BasselKhaled24/Gyroscopic-Boat-Stabilization-System/README.md

# Gyroscopic-Boat-Stabilization-System
This is a university (GUC) Project where we actuated a gyroscope to balance a boat experiencing disturbance.

All 3D Models can be found here https://grabcad.com/library/gyroscopic-boat-stabilization-system-1

Credit to:
Bassel Abdelhaleem,
Omar Elshemerly,
Mohamed Abdelrahman
