BasselKhaled24/Gyroscopic-Boat-Stabilization-System/Gyroscopic Boat Stabilization System/3D Models/Servo Brackets v4.obj

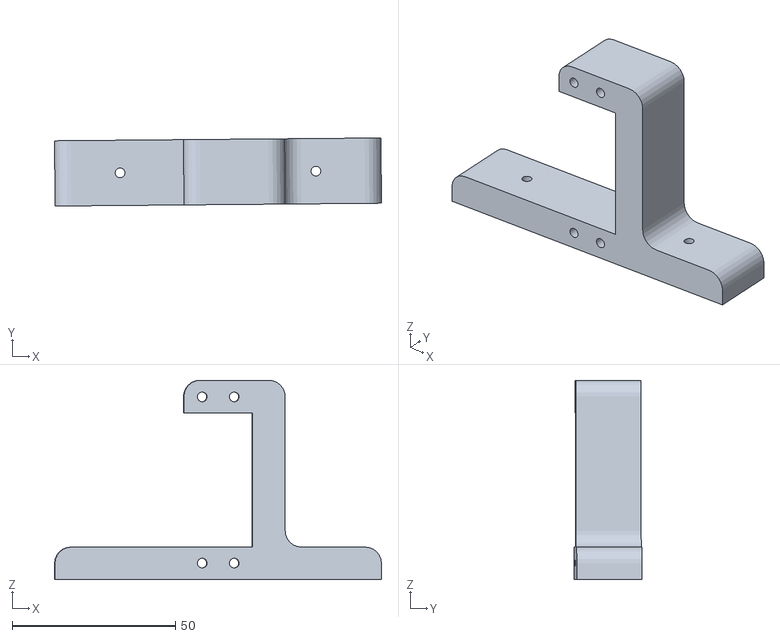
[picture p13: CAD file, 2023-02-15]
Gyroscopic Boat Stabilization System/3D Models/Servo Brackets v4.obj
100.2 x 20.9 x 61.1
