BasselKhaled24/Gyroscopic-Boat-Stabilization-System/Gyroscopic Boat Stabilization System/3D Models/Gyro Wheel v7.obj

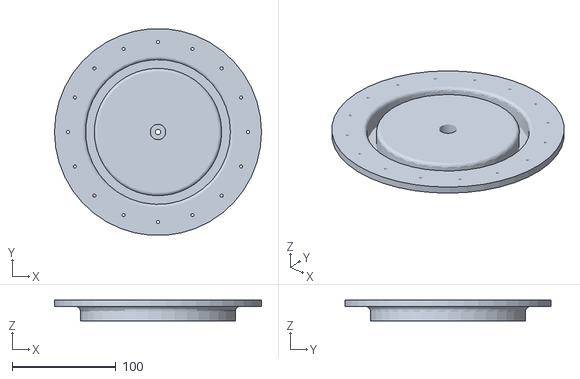
[picture p14: CAD file, 2023-02-15]
Gyroscopic Boat Stabilization System/3D Models/Gyro Wheel v7.obj
200.0 x 199.4 x 20.0
