BasselKhaled24/Gyroscopic-Boat-Stabilization-System/Gyroscopic Boat Stabilization System/3D Models/Servo Horn v1.obj

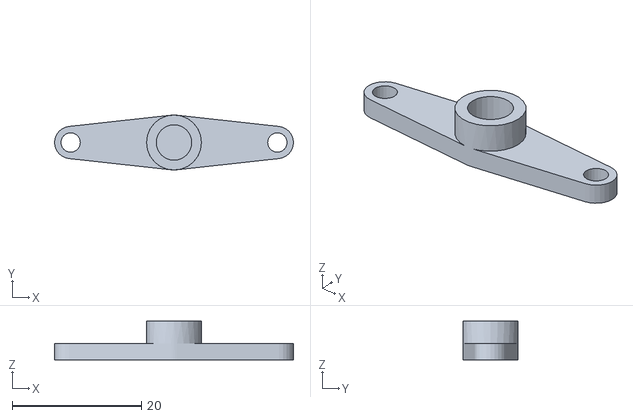
[picture p15: CAD file, 2023-02-15]
Gyroscopic Boat Stabilization System/3D Models/Servo Horn v1.obj
37.0 x 8.50 x 6.00
