BasselKhaled24/Gyroscopic-Boat-Stabilization-System/Gyroscopic Boat Stabilization System/3D Models/Base (Left Half) v4.obj

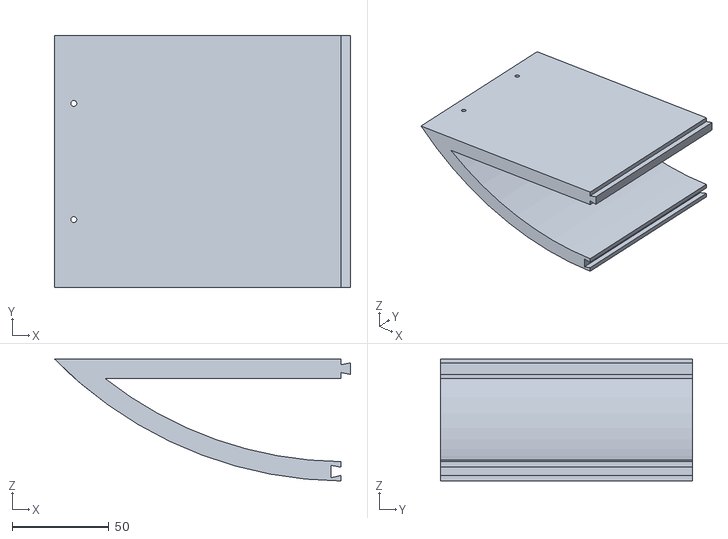
[picture p16: CAD file, 2023-02-15]
Gyroscopic Boat Stabilization System/3D Models/Base (Left Half) v4.obj
153.0 x 130.0 x 63.0
