BasselKhaled24/Gyroscopic-Boat-Stabilization-System/Gyroscopic Boat Stabilization System/3D Models/Base (Right Half) v1.obj

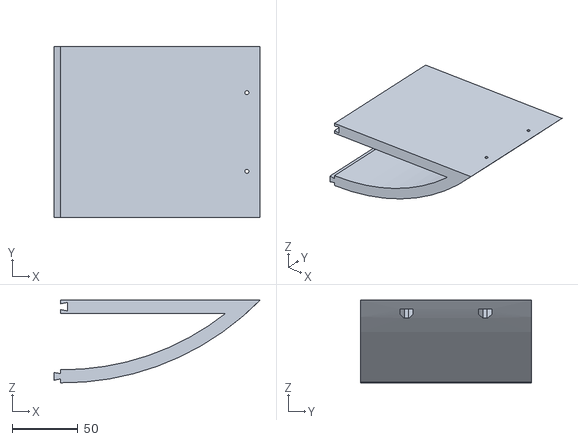
[picture p17: CAD file, 2023-02-15]
Gyroscopic Boat Stabilization System/3D Models/Base (Right Half) v1.obj
157.0 x 130.0 x 63.0
