BasselKhaled24/Gyroscopic-Boat-Stabilization-System/Gyroscopic Boat Stabilization System/3D Models/servo bracket v4 v3.obj

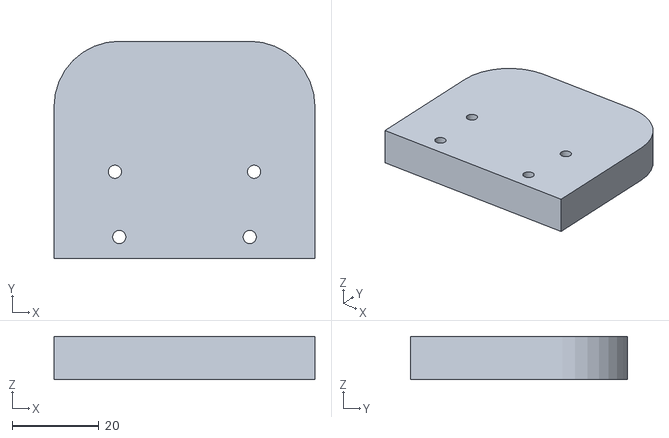
[picture p18: CAD file, 2023-02-15]
Gyroscopic Boat Stabilization System/3D Models/servo bracket v4 v3.obj
60.0 x 50.0 x 10.0
