BasselKhaled24/Gyroscopic-Boat-Stabilization-System/Gyroscopic Boat Stabilization System/3D Models/motor bracket v2 v6.obj

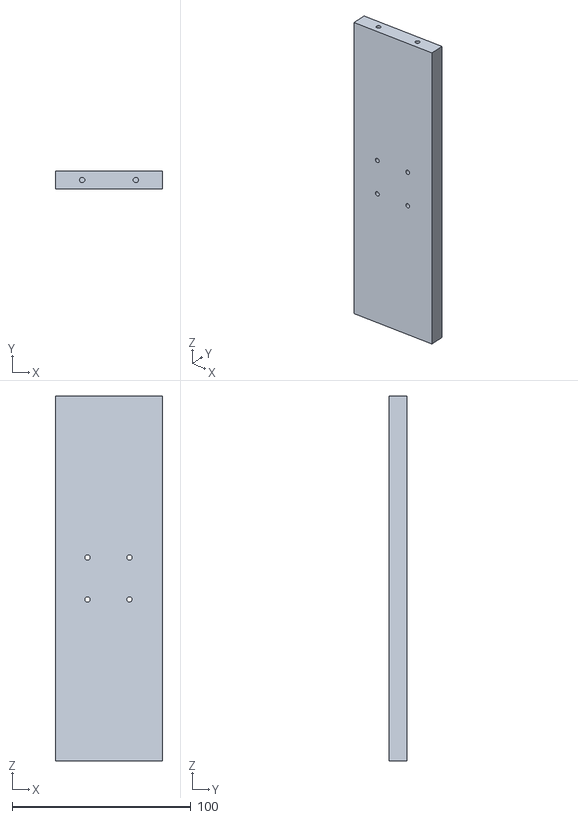
[picture p19: CAD file, 2023-02-15]
Gyroscopic Boat Stabilization System/3D Models/motor bracket v2 v6.obj
60.0 x 10.0 x 204.0
